411Group1Together/Project/Project-master/December 1st Update.pdf

Brandon Towell <brandon.towell@gmail.com>

## Progress Report

1 message

Brandon Towell <brandon.towell@gmail.com> | Mon, Dec 1, 2014 at 3:22 PM
To: Kris Gibbs <kris.gibbs888@gmail.com>, Ryan Oconnor <roconnor@pdx.edu>, "jmickiew@pdx.edu" <jmickiew@pdx.edu>

Last Week:
Added button wiring
Soldered and hooked up buttons to boards
Ran through connectivity tests in software to confirm button function

Next Week:
Get enclosure and mount buttons, switches, and screen.
Mount battery enclosure
rework analog pins for player 4
run through test cases to find hangups
run game finish to start to find errors
Brandon Towell
(971) 217-7102
