411Group1Together/Project/Project-master/411Group1Together/Schematic.git/image.png

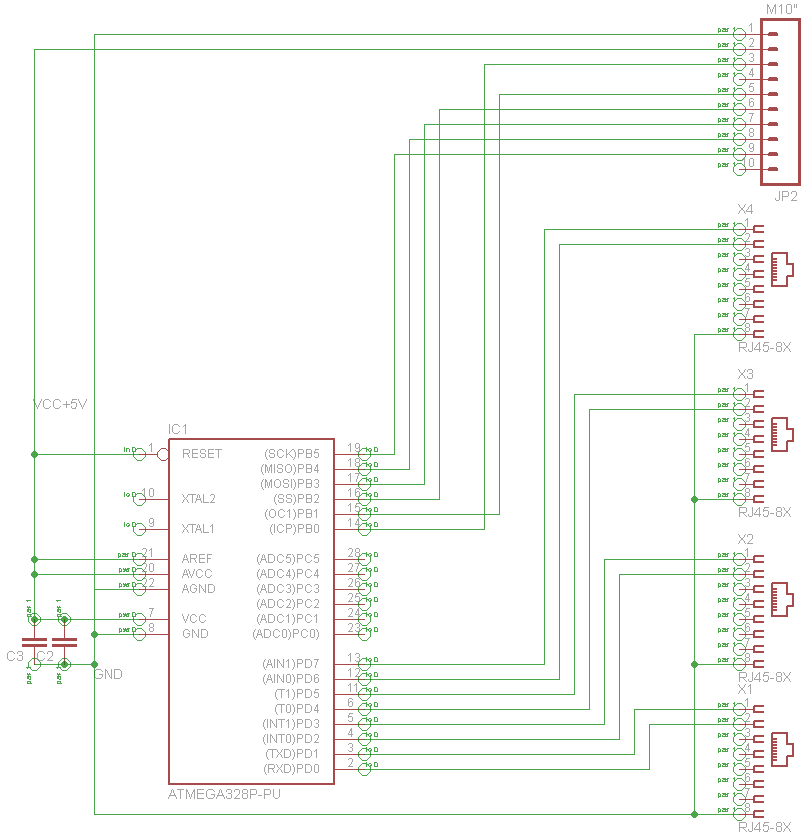
Project-master/411Group1Together/Schematic.git/image.png
