411Group1Together/Project/Project-master/BOM.xlsx

Part Name | Part Number | Revision | Quantity per board | Unit of Measure | Mounting Style | Cost 1 | Cost 10 | Cost 100 | Cost 1000
Ethernet header | 649-54602-910LF | A | 4 | each | TH | $0.620 | $0.576 | $0.442 | $0.317
5v linear regulator | 863-NCP4625DSN50T1G | A | 1 | each | SMT | $0.890 | $0.708 | $0.544 | $0.379
16M crystal | 717-AS-16.000MAHK-B | A | 1 | each | TH | $0.500 | $0.450 | $0.332 | $0.271
10k resistor | 667-ERJ-3EKF1002V | A | 11 | each | SMT | $0.100 | $0.014 | $0.009 | $0.004
0.1uF capacitor | 81-GRM39X104K25 | A | 7 | each | SMT | $0.100 | $0.011 | $0.007 | $0.005
1uF capacitors | 81-GRM188R61E105KA12 | A | 2 | each | SMT | $0.040 | $0.026 | $0.022 | $0.016
12pF capacitor | 81-GRM185C1H120FA01D | A | 2 | each | SMT | $0.160 | $0.064 | $0.037 | $0.031
28 pin socket | 517-4828-3004-CP (http://www.mouser.com/ProductDetail/3M-Electronic-Solutions-Division/4828-3004-CP/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) | A | 1 | each | TH | $0.470 | $0.457 | $0.406 | $0.406
Stand-offs | 761-4542-440-N | A | 4 | each | N/A | $0.500 | $0.500 | $0.440 | $0.377
 |  |  |  | each
Micro-controller with bootloader | https://www.adafruit.com/products/123 | A | 1 | each | N/A | $5.950 | $5.360 | $4.760 | $4.760
buttons | https://www.adafruit.com/products/1190 ,1191,1193,1194 | A | 4 | each | N/A | $5.950 | $5.360 | $4.760 | $4.760
display | https://www.adafruit.com/products/1480 | A | 1 | each | TH | $24.950 | $24.950 | $19.960 | $19.960
Power switch | 642-631H | B | 1 | each | TH | $5.320 | $5.320 | $4.440 | $3.990
Reset switch | 691-6FC53-73/TABS | B | 1 | each | SMT | $6.200 | $6.200 | $4.530 | $3.100
9v battery | 658-6LR61XWA (http://www.mouser.com/ProductDetail/Panasonic-Battery/6LR61XWA-B/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) | C | 1 | each | TH | $2.030 | $1.820 | $1.620 | $1.220
battery pack | 534-1295 | C | 1 | each | N/A | $2.000 | $2.000 | $1.860 | $1.040
micro-controller without bootloader | 556-ATMEGA328P-PU | A | 0 | each | N/A | $3.550 | $3.130 | $2.350 | $1.860
 |  |  |  | each
acrylic | usplastic.com/catalog/item.aspx?itemid=34617&catid=442 | A | 1.25 | each | N/A | $11.280 | $11.280 | $11.280 | $11.280
ethernet cable | 562-1225028-03 | A | 4 | each | N/A | $1.570 | $1.490 | $1.350 | $0.998
strain relief | 571-558527-3 | B | 4 | each | N/A | $0.470 | $0.470 | $0.353 | $0.257
magnets |  | C | 8 | each | N/A | $0.199 | $0.199 | $0.199 | $0.199
 |  |  | per unit |  |  | $102.64 | $96.95 | $83.79 | $77.83
 |  |  | total |  |  | $410.57 | $969.52 | $8379.00 | $77827.00
 |  |  | total SMT |  | 72.73%
