411Group1Together/Project/Project-master/411Group1Together/Schematic.git/T05_version11_9b.brd

## EAGLE design Project-master/411Group1Together/Schematic.git/T05_version11_9b.brd (2014-11-10)

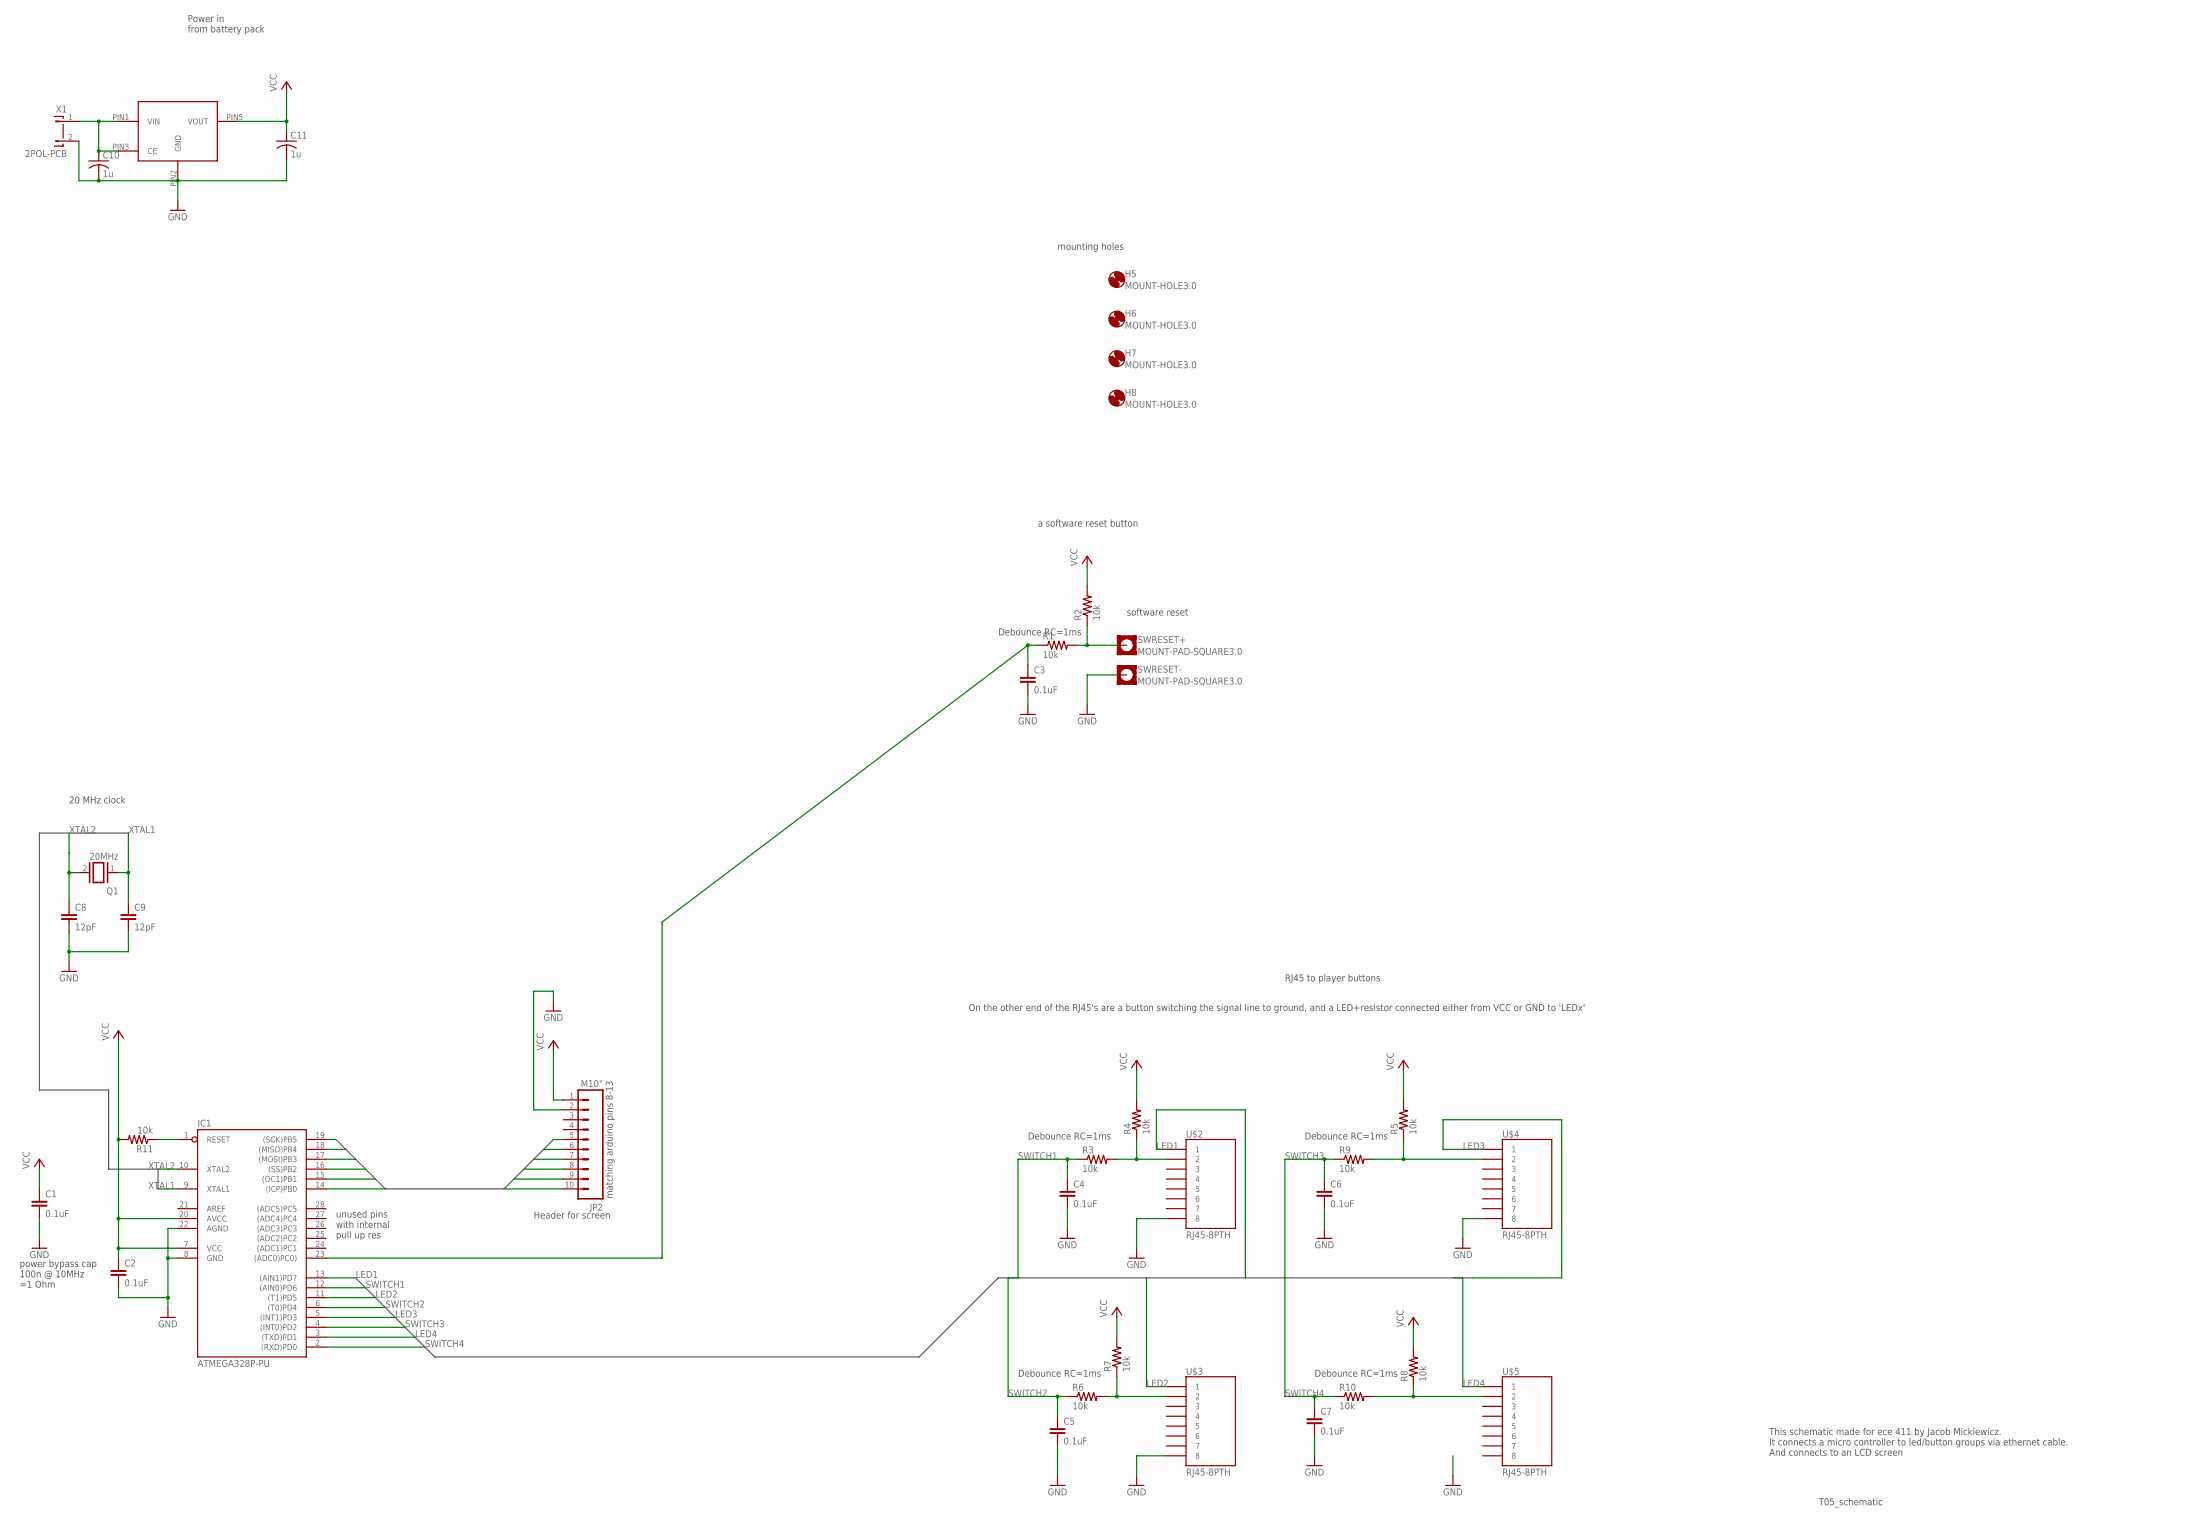
[picture p8: schematic T05_version11_9b.sch]

Parts:
C1, C2, C3, C4, C5, C6, C7: 0.1uF; 0603-CAP
C8, C9: 12pF; 0603-CAP
C10, C11: 1u; C0603
H5, H6, H7, H8: MOUNT-HOLE3.0; 3,0
IC1: ATMEGA328P-PU; DIL28-3
JP2: M10"; 1X10
Q1: 20MHz; QS
R1, R2, R3, R4, R5, R6, R7, R8, R9, R10, R11: 10k; 0603-RES
SWRESET+: MOUNT-PAD-SQUARE3.0; 3,0-PAD-SQUARE
SWRESET-: MOUNT-PAD-SQUARE3.0; 3,0-PAD-SQUARE
U$1: NCP4625
U$2, U$3, U$4, U$5: RJ45-8PTH; RJ45-8
X1: 2POL-PCB

Connections:
GND: C1.2, C2.2, C3.2, C4.2, C5.2, C6.2, C7.2, C8.2, C9.2, C10.2, C11.2, IC1.8 (GND), IC1.22 (AGND), JP2.2, SWRESET-.B3,0, U$1.PIN2 (GND), U$2.8, U$3.8, U$4.8, X1.2
ICP: IC1.14 ((ICP)PB0), JP2.10
LED1: IC1.13 ((AIN1)PD7), U$2.1
LED2: IC1.11 ((T1)PD5), U$3.1
LED3: IC1.5 ((INT1)PD3), U$4.1
LED4: IC1.3 ((TXD)PD1), U$5.1
MISO: IC1.18 ((MISO)PB4), JP2.6
MOSI: IC1.17 ((MOSI)PB3), JP2.7
unnamed: IC1.1 (RESET), R11.1
unnamed: R3.2, R4.1, U$2.2
unnamed: R8.1, R10.2, U$5.2
unnamed: R1.2, R2.1, SWRESET+.B3,0
unnamed: R6.2, R7.1, U$3.2
unnamed: R5.1, R9.2, U$4.2
unnamed: C10.1, U$1.PIN1 (VIN), U$1.PIN3 (CE), X1.1
OC1: IC1.15 ((OC1)PB1), JP2.9
SCK: IC1.19 ((SCK)PB5), JP2.5
SS: IC1.16 ((SS)PB2), JP2.8
SWITCH1: C4.1, IC1.12 ((AIN0)PD6), R3.1
SWITCH2: C5.1, IC1.6 ((T0)PD4), R6.1
SWITCH3: C6.1, IC1.4 ((INT0)PD2), R9.1
SWITCH4: C7.1, IC1.2 ((RXD)PD0), R10.1
SW_RESET: C3.1, IC1.23 ((ADC0)PC0)), R1.1
VCC: C1.1, C2.1, C11.1, IC1.7 (VCC), IC1.20 (AVCC), JP2.1, R2.2, R4.2, R5.2, R7.2, R8.2, R11.2, U$1.PIN5 (VOUT)
XTAL1: C9.1, IC1.9 (XTAL1), Q1.1
XTAL2: C8.1, IC1.10 (XTAL2), Q1.2

Notes on the sheet:
power bypass cap 100n @ 10MHz =1 Ohm
Header for screen
Debounce RC=1ms
software reset
RJ45 to player buttons
unused pins with internal pull up res
T05_schematic
matching arduino pins 8-13
This schematic made for ece 411 by Jacob Mickiewicz. It connects a micro controller to led/button groups via ethernet cable. And connects to an LCD screen
On the other end of the RJ45's are a button switching the signal line to ground, and a LED+resistor connected either from VCC or GND to 'LEDx'
Power in from battery pack
a software reset button
mounting holes
20 MHz clock

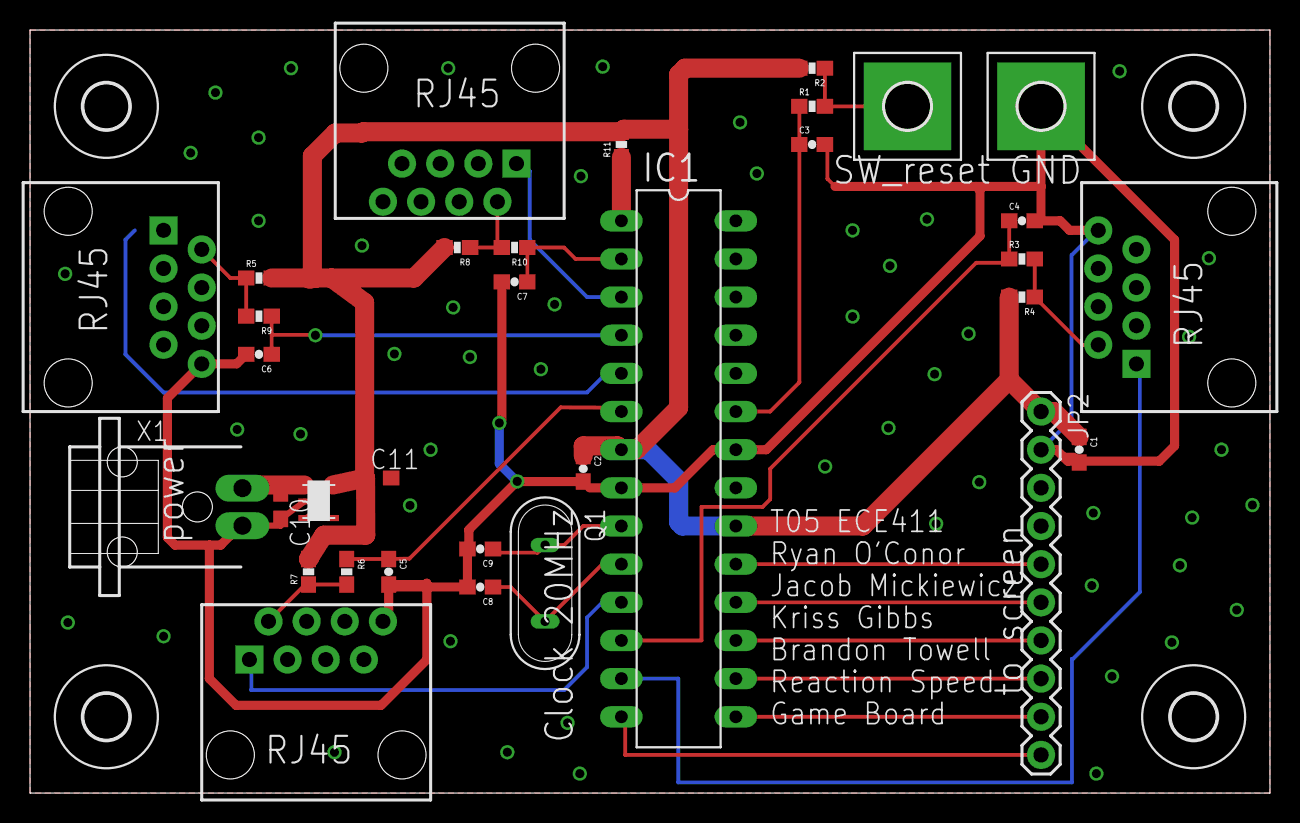
[picture p9: board T05_version11_9b.brd from above]

Board: 2 copper layers, 82.5 x 50.8 mm, 37 parts (0 on the bottom side), 26 nets.
