411Group1Together/Project/Project-master/411Group1Together/Schematic.git/version10_25.brd

## EAGLE design Project-master/411Group1Together/Schematic.git/version10_25.brd (2014-11-10, an earlier design)

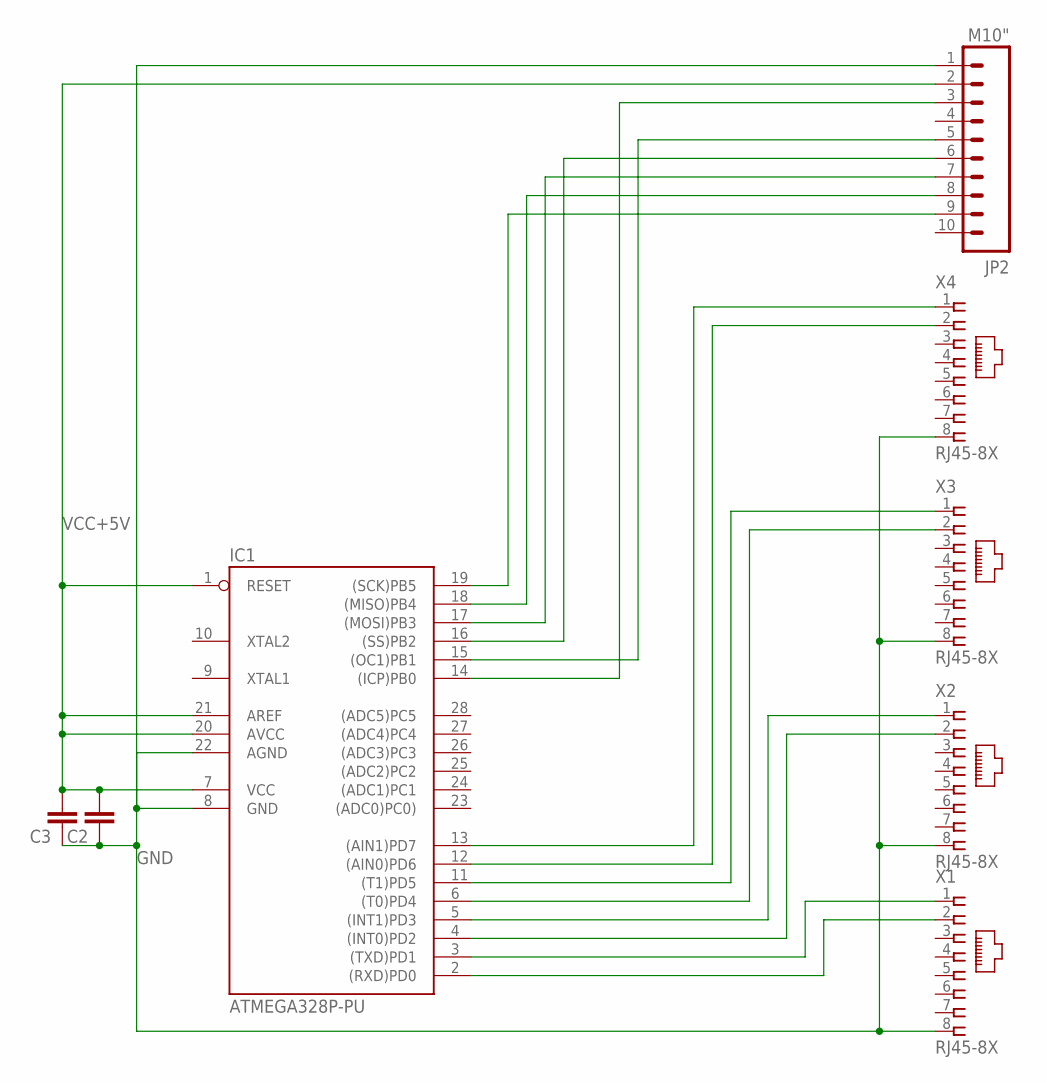
[picture p10: schematic version10_25.sch]

Parts:
C2, C3: CAP1206; 1206
IC1: ATMEGA328P-PU; DIL28-3
JP2: M10"; 1X10
X1, X2, X3, X4: RJ45-8X; RJ45-NO-SHIELD

Connections:
GND: C2.1, C3.1, IC1.8 (GND), IC1.22 (AGND), JP2.1, X1.8, X2.8, X3.8, X4.8
unnamed: IC1.19 ((SCK)PB5), JP2.9
unnamed: IC1.18 ((MISO)PB4), JP2.8
unnamed: IC1.15 ((OC1)PB1), JP2.5
unnamed: IC1.17 ((MOSI)PB3), JP2.7
unnamed: IC1.16 ((SS)PB2), JP2.6
unnamed: IC1.14 ((ICP)PB0), JP2.3
unnamed: IC1.2 ((RXD)PD0), X1.2
unnamed: IC1.3 ((TXD)PD1), X1.1
unnamed: IC1.4 ((INT0)PD2), X2.2
unnamed: IC1.5 ((INT1)PD3), X2.1
unnamed: IC1.6 ((T0)PD4), X3.2
unnamed: IC1.11 ((T1)PD5), X3.1
unnamed: IC1.12 ((AIN0)PD6), X4.2
unnamed: IC1.13 ((AIN1)PD7), X4.1
VCC+5V: C2.2, C3.2, IC1.1 (RESET), IC1.7 (VCC), IC1.20 (AVCC), IC1.21 (AREF), JP2.2

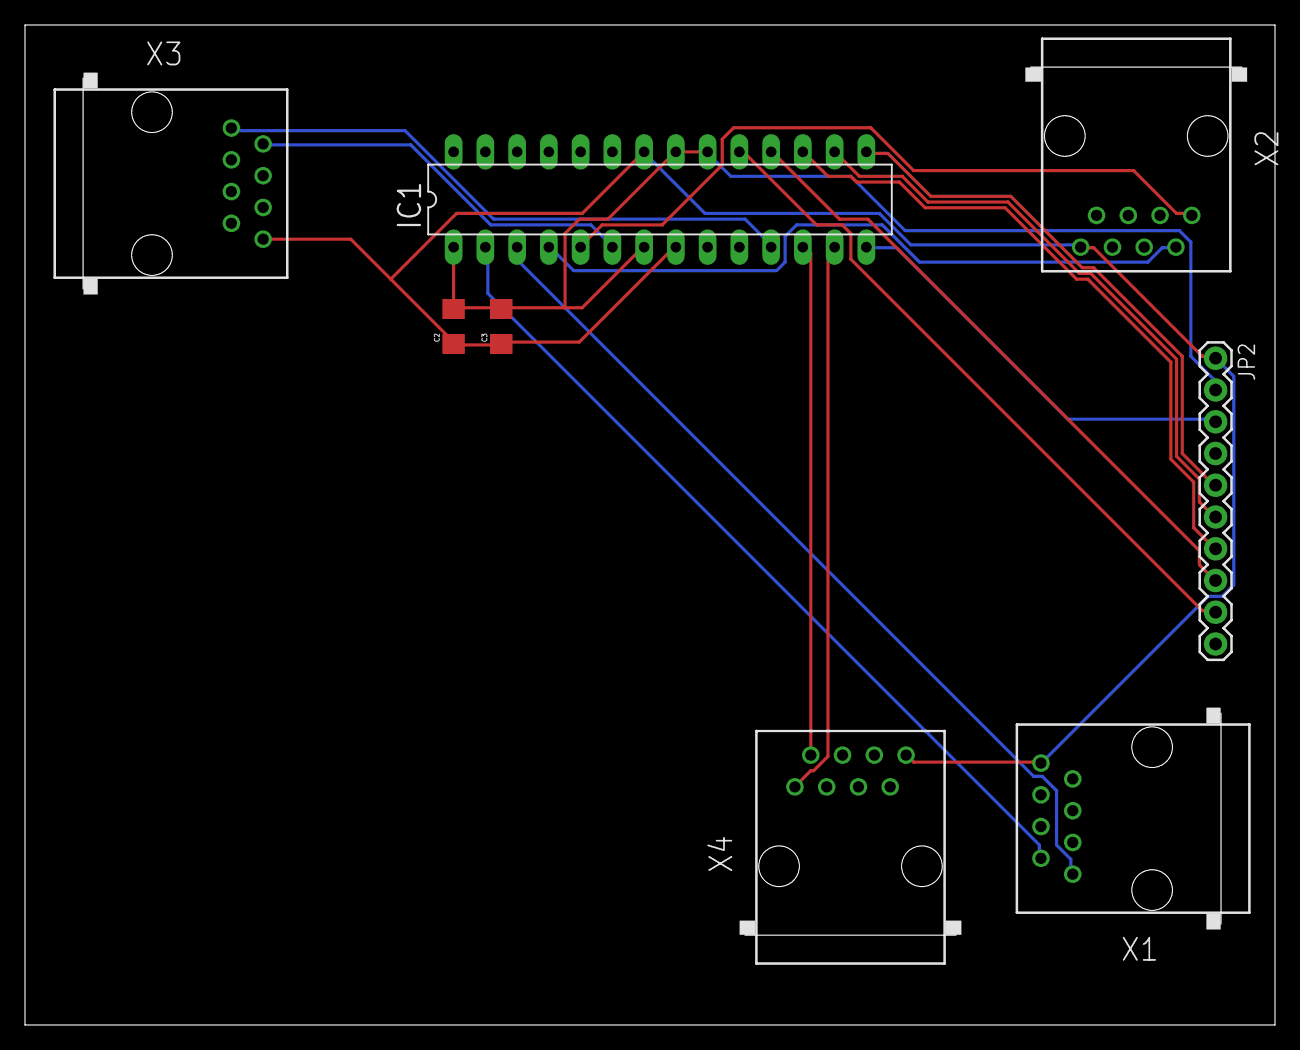
[picture p11: board version10_25.brd from above]

Board: 2 copper layers, 100.0 x 80.0 mm, 8 parts (0 on the bottom side), 16 nets.
