411Group1Together/Project/(commit log)

2014-11-10 updated power, gnd.
    [T05_version11_2.brd, T05_version11_2.sch, T05_version11_3.brd, T05_version11_3.sch, T05_version11_7b.brd, T05_version11_7b.sch, T05_version11_8.brd, T05_version11_8.sch]
2014-11-10 ran drc/erc. fixed a clearence and some naming.
    [T05_version11_9b.brd, T05_version11_9b.sch]
2014-12-12 checked in arduino code
2014-12-12 fixed winner evaluation case
    [ReactionGameActual2.ino]
2014-12-12 fixed the display of the winner
    added a winners time in milliseconds
    [ReactionGameActual2.ino]
2014-12-12 fixed winner declaration
    there was a bug that if someone didn’t push their button they would be
    declared the winner
    [ReactionGameActual2.ino]
2014-12-12 bom breakdown
    [BOM.xlsx]
2014-12-12 final code upload.
    changed the way the button press is captured
